stoyan-shopov/vx-probe-blackmagic-v2-kicad/vx-probe-black-magic-v2.kicad_pcb

## KiCad design vx-probe-black-magic-v2.kicad_pcb (2016-10-07)

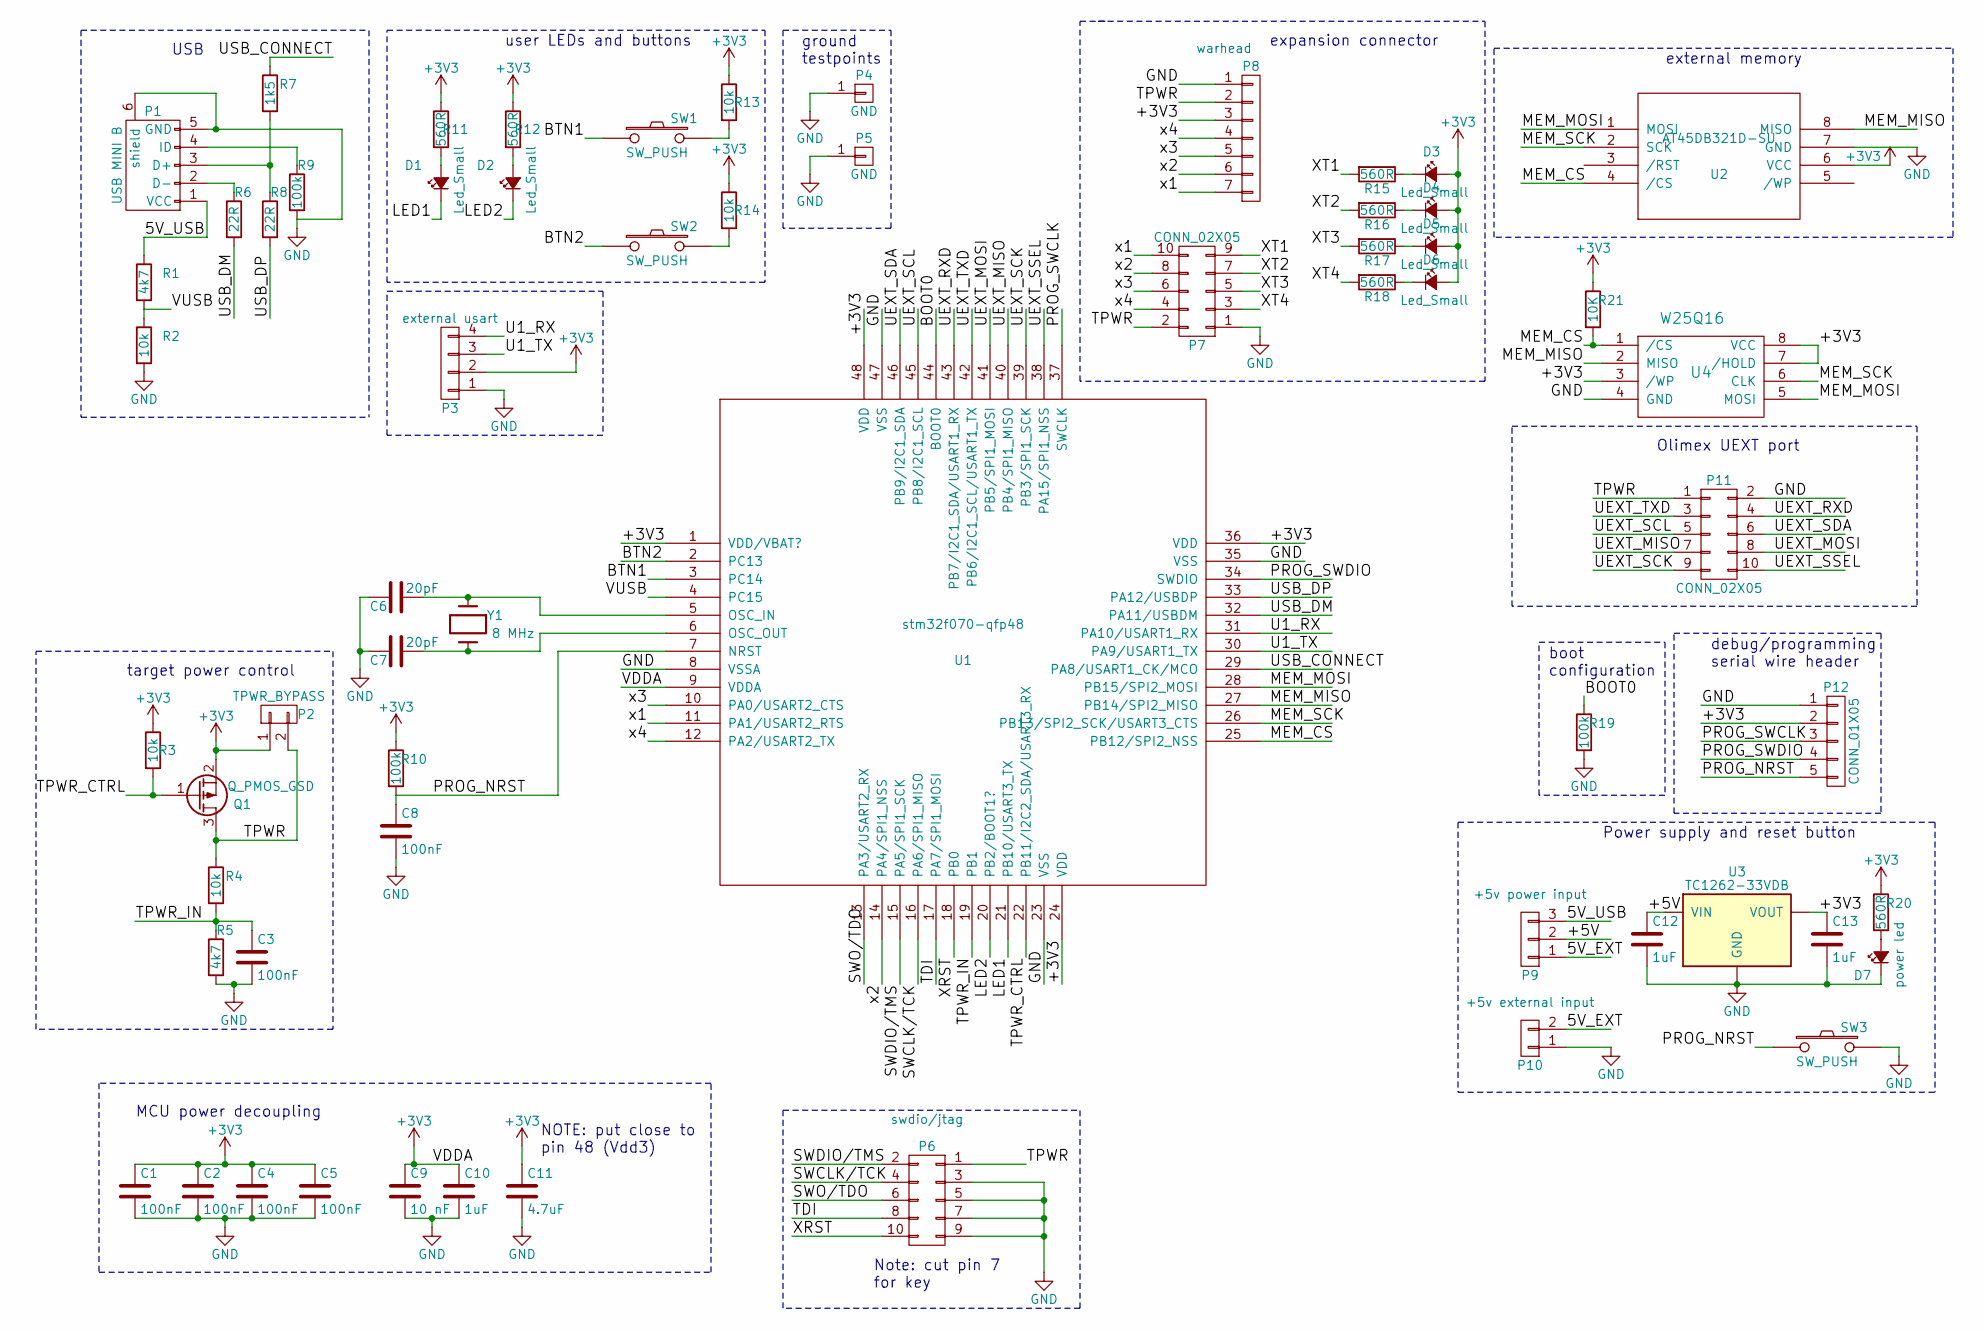
[picture p2: schematic vx-probe-black-magic-v2.sch]

Parts:
C1, C2, C3, C4, C5, C8: 100nF; C_0805
C6, C7: 20pF; C_0805
C9: 10 nF; C_0805
C10, C12, C13: 1uF; C_0805
C11: 4.7uF; C_0805
D1, D2, D3, D4, D5, D6: Led_Small; LED_0805
D7: power led; LED_0805
P1: USB MINI B; USB_Mini-B
P2: TPWR_BYPASS; Pin_Header_Straight_1x02
P3: external usart; Pin_Header_Straight_1x04
P4, P5: GND; Pin_Header_Straight_1x01
P6: swdio/jtag; IDC_Header_Straight_10pins
P7: CONN_02X05; Pin_Header_Straight_2x05
P8: warhead; Pin_Header_Straight_1x07
P9: +5v power input; Pin_Header_Straight_1x03
P10: +5v external input; Pin_Header_Straight_1x02
P11: CONN_02X05; IDC_Header_Straight_10pins
P12: CONN_01X05; Pin_Header_Straight_1x05
Q1: Q_PMOS_GSD; SOT-23
R1, R5: 4k7; R_0805
R2, R3, R4, R13, R14: 10k; R_0805
R6, R8: 22R; R_0805
R7: 1k5; R_0805
R9, R10, R19: 100k; R_0805
R11, R12, R15, R16, R17, R18, R20: 560R; R_0805
R21: 10K; R_0805
SW1, SW2, SW3: SW_PUSH; SW_PUSH_6mm
U1: stm32f070-qfp48; LQFP-48_7x7mm_Pitch0.5mm
U2: AT45DB321D-SU; SOIJ-8_5.3x5.3mm_Pitch1.27mm
U3: TC1262-33VDB; SOT-223
U4: W25Q16; SOIJ-8_5.3x5.3mm_Pitch1.27mm
Y1: 8 MHz; Crystal_HC49-U_Vertical

Connections:
+3V3: C1.1, C2.1, C4.1, C5.1, C9.1, C10.1, C11.1, C13.1, D3.2 (A), D4.2 (A), D5.2 (A), D6.2 (A), P2.1, P3.2, P8.3, P12.2, Q1.2 (S), R3.1, R10.1, R11.1, R12.1, R13.1, R14.1, R20.1, R21.1, U1.1 (VDD/VBAT?), U1.9 (VDDA), U1.24 (VDD), U1.36 (VDD), U1.48 (VDD), U2.6 (VCC), U3.3 (VOUT), U4.3 (/WP), U4.7 (/HOLD), U4.8 (VCC)
/5V_EXT: P9.1, P10.2
/5V_USB: P1.1 (VCC), P9.3, R1.1
/+5V: C12.1, P9.2, U3.1 (VIN)
/BOOT0: R19.1, U1.44 (BOOT0)
/BTN1: SW1.1, U1.3 (PC14)
/BTN2: SW2.1, U1.2 (PC13)
/LED1: D1.1 (K), U1.21 (PB10/USART3_TX)
/LED2: D2.1 (K), U1.20 (PB2/BOOT1?)
/MEM_CS: R21.2, U1.25 (PB12/SPI2_NSS), U2.4 (/CS), U4.1 (/CS)
/MEM_MISO: U1.27 (PB14/SPI2_MISO), U2.8 (MISO), U4.2 (MISO)
/MEM_MOSI: U1.28 (PB15/SPI2_MOSI), U2.1 (MOSI), U4.5 (MOSI)
/MEM_SCK: U1.26 (PB13/SPI2_SCK/USART3_CTS), U2.2 (SCK), U4.6 (CLK)
/PROG_NRST: C8.1, P12.5, R10.2, SW3.1, U1.7 (NRST)
/PROG_SWCLK: P12.3, U1.37 (SWCLK)
/PROG_SWDIO: P12.4, U1.34 (SWDIO)
/SWCLK/TCK: P6.4, U1.16 (PA6/SPI1_MISO)
/SWDIO/TMS: P6.2, U1.15 (PA5/SPI1_SCK)
/SWO/TDO: P6.6, U1.13 (PA3/USART2_RX)
/TDI: P6.8, U1.17 (PA7/SPI1_MOSI)
/TPWR: P2.2, P6.1, P7.2, P8.2, P11.1, Q1.3 (D), R4.1
/TPWR_CTRL: Q1.1 (G), R3.2, U1.22 (PB11/I2C2_SDA/USART3_RX)
/TPWR_IN: C3.1, R4.2, R5.1, U1.19 (PB1)
/U1_RX: P3.4, U1.31 (PA10/USART1_RX)
/U1_TX: P3.3, U1.30 (PA9/USART1_TX)
/UEXT_MISO: P11.7, U1.40 (PB4/SPI1_MISO)
/UEXT_MOSI: P11.8, U1.41 (PB5/SPI1_MOSI)
/UEXT_RXD: P11.4, U1.43 (PB7/I2C1_SDA/USART1_RX)
/UEXT_SCK: P11.9, U1.39 (PB3/SPI1_SCK)
/UEXT_SCL: P11.5, U1.45 (PB8/I2C1_SCL)
/UEXT_SDA: P11.6, U1.46 (PB9/I2C1_SDA)
/UEXT_SSEL: P11.10, U1.38 (PA15/SPI1_NSS)
/UEXT_TXD: P11.3, U1.42 (PB6/I2C1_SCL/USART1_TX)
/USB_CONNECT: R7.1, U1.29 (PA8/USART1_CK/MCO)
/USB_DM: R6.2, U1.32 (PA11/USBDM)
/USB_DP: R8.2, U1.33 (PA12/USBDP)
/VUSB: R1.2, R2.1, U1.4 (PC15)
/XRST: P6.10, U1.18 (PB0)
/XT1: P7.9, R15.2
/XT2: P7.7, R16.2
/XT3: P7.5, R17.2
/XT4: P7.3, R18.2
/x1: P7.10, P8.7, U1.11 (PA1/USART2_RTS)
/x2: P7.8, P8.6, U1.14 (PA4/SPI1_NSS)
/x3: P7.6, P8.5, U1.10 (PA0/USART2_CTS)
/x4: P7.4, P8.4, U1.12 (PA2/USART2_TX)
GND: C1.2, C2.2, C3.2, C4.2, C5.2, C6.2, C7.2, C8.2, C9.2, C10.2, C11.2, C12.2, C13.2, D7.1 (K), P1.5 (GND), P1.6 (shield), P3.1, P4.1, P5.1, P6.3, P6.5, P6.7, P6.9, P7.1, P8.1, P10.1, P11.2, P12.1, R2.2, R5.2, R9.2, R19.2, SW3.2, U1.8 (VSSA), U1.23 (VSS), U1.35 (VSS), U1.47 (VSS), U2.7 (GND), U3.2 (GND), U3.4 (GND), U4.4 (GND)
unnamed: C6.1, U1.5 (OSC_IN), Y1.1
unnamed: C7.1, U1.6 (OSC_OUT), Y1.2
unnamed: D1.2 (A), R11.2
unnamed: D2.2 (A), R12.2
unnamed: D3.1 (K), R15.1
unnamed: D4.1 (K), R16.1
unnamed: D5.1 (K), R17.1
unnamed: D6.1 (K), R18.1
unnamed: D7.2 (A), R20.2
unnamed: P1.2 (D-), R6.1
unnamed: P1.3 (D+), R7.2, R8.1
unnamed: P1.4 (ID), R9.1
unnamed: R13.2, SW1.2
unnamed: R14.2, SW2.2

Notes on the sheet:
MCU power decoupling
USB
external memory
Olimex UEXT port
NOTE: put close to pin 48 (Vdd3)
debug/programming serial wire header
boot configuration
Power supply and reset button
Note: cut pin 7 for key
user LEDs and buttons
ground testpoints
expansion connector
target power control

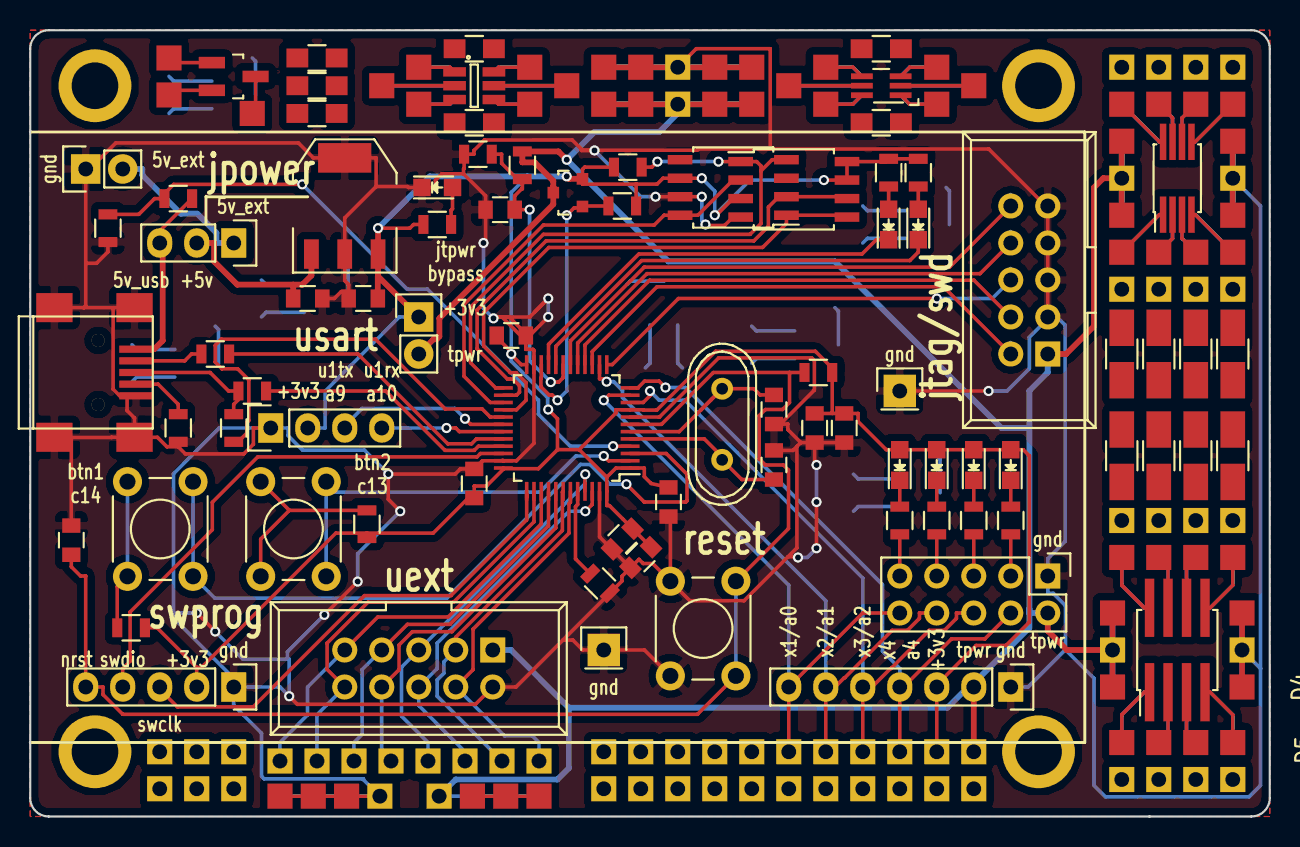
[picture p3: board vx-probe-black-magic-v2.kicad_pcb from above]

Board: 2 copper layers, 85.1 x 54.0 mm, 62 parts (0 on the bottom side), 61 nets.
