stoyan-shopov/vx-probe-blackmagic-v2-kicad/(commit log)

2016-09-13 new project created
    [vx-probe-black-magic-v2.kicad_pcb, vx-probe-black-magic-v2.sch]
2016-09-13 stm32f103 part datasheet added
2016-09-13 started schematics drawing
    [vx-probe-black-magic-v2.sch]
2016-09-13 reset circuit added
    [vx-probe-black-magic-v2.sch]
2016-09-13 started assigning component footprints
    [vx-probe-black-magic-v2.sch]
2016-09-13 added the mcu power decoupling
    [vx-probe-black-magic-v2.sch]
2016-09-13 drew the usb connection
    [vx-probe-black-magic-v2.sch]
2016-09-13 assigned more component footprints
    [vx-probe-black-magic-v2.sch]
2016-09-13 updated the pcb
    [vx-probe-black-magic-v2.kicad_pcb]
2016-09-13 added the at45db32 library part
    [vx-probe-black-magic-v2.sch]
2016-09-13 assigned the at45db32 part footprint
    [vx-probe-black-magic-v2.kicad_pcb, vx-probe-black-magic-v2.sch]
2016-09-13 wired up the external spi memory
    [vx-probe-black-magic-v2.sch]
2016-09-13 wired up the olimex UEXT port
    [vx-probe-black-magic-v2.sch]
2016-09-13 added the original blackmagic probe schematics for reference
2016-09-13 added missing pull-up resistor on the usb-data-plus line
    [vx-probe-black-magic-v2.sch]
2016-09-13 added serial wire debug/programming header
    [vx-probe-black-magic-v2.sch]
2016-09-13 added boot selection setup
    [vx-probe-black-magic-v2.sch]
2016-09-13 added power supply block
    [vx-probe-black-magic-v2.sch]
2016-09-13 made capacitor values more readable
    [vx-probe-black-magic-v2.sch]
2016-09-13 updated components' annotations and footprints
    [vx-probe-black-magic-v2.kicad_pcb, vx-probe-black-magic-v2.sch]
2016-09-13 added missing wires, started placing components
    [vx-probe-black-magic-v2.kicad_pcb, vx-probe-black-magic-v2.sch]
2016-09-14 adjusted minimum via diametercls
    [vx-probe-black-magic-v2.kicad_pcb]
2016-09-14 pcb manufacturer document file added
2016-09-14 started placing and routing the swdio/jtag connector
    [vx-probe-black-magic-v2.kicad_pcb, vx-probe-black-magic-v2.sch]
2016-09-14 routing optimizations
    [vx-probe-black-magic-v2.kicad_pcb, vx-probe-black-magic-v2.sch]
2016-09-14 7 vias
    [vx-probe-black-magic-v2.kicad_pcb]
2016-09-14 9 vias
    [vx-probe-black-magic-v2.kicad_pcb]
2016-09-14 8 vias
    [vx-probe-black-magic-v2.kicad_pcb]
2016-09-15 11 vias
    [vx-probe-black-magic-v2.kicad_pcb, vx-probe-black-magic-v2.sch]
2016-09-15 removed i2c bus pull-up resistors
    [vx-probe-black-magic-v2.kicad_pcb, vx-probe-black-magic-v2.sch]
2016-09-15 stm32f070 breakout board schematics added for reference
2016-09-15 stm nucleo-64 boards user manual added for reference
2016-09-15 reorganized layout, autorouting to 7 vias
    [vx-probe-black-magic-v2.kicad_pcb]
2016-09-15 defined board dimensions
    [vx-probe-black-magic-v2.kicad_pcb]
2016-09-15 started fitting the components inside the board space, autorouting to 14 vias
    [vx-probe-black-magic-v2.kicad_pcb]
2016-09-15 autorouting to 8 vias
    [vx-probe-black-magic-v2.kicad_pcb]
2016-09-15 displaced the connectors, autorouting to 8 vias
    [vx-probe-black-magic-v2.kicad_pcb]
2016-09-15 adding dummy keep-off areas
    [vx-probe-black-magic-v2.kicad_pcb, vx-probe-black-magic-v2.sch]
2016-09-15 adding dummy keep-off areas, autorouting to 9 vias
    [vx-probe-black-magic-v2.kicad_pcb]
2016-09-15 adding dummy keep-off areas, autorouting to 5 vias
    [vx-probe-black-magic-v2.kicad_pcb]
2016-09-15 placed unused pins utilization connector, autorouting to 13 vias
    [vx-probe-black-magic-v2.kicad_pcb, vx-probe-black-magic-v2.sch]
2016-09-15 bundled tracks closer to each other
    [vx-probe-black-magic-v2.kicad_pcb, vx-probe-black-magic-v2.sch]
2016-09-15 test-routed unused pins
    [vx-probe-black-magic-v2.kicad_pcb]
2016-09-15 bundled the uext signals closer together
    [vx-probe-black-magic-v2.kicad_pcb]
2016-09-16 track layout optimizations
    [vx-probe-black-magic-v2.kicad_pcb]
2016-09-16 added target power control circuitry
    [vx-probe-black-magic-v2.sch]
2016-09-16 initial routing of the target power control circuitry
    [vx-probe-black-magic-v2.kicad_pcb, vx-probe-black-magic-v2.sch]
2016-09-16 added and routed the 'vbus' usb power detection signal
    [vx-probe-black-magic-v2.kicad_pcb, vx-probe-black-magic-v2.sch]
2016-09-16 routed an unused pin to the 'unused pins' connector
    [vx-probe-black-magic-v2.kicad_pcb, vx-probe-black-magic-v2.sch]
2016-09-16 reorganized the unused pins connector
    [vx-probe-black-magic-v2.kicad_pcb, vx-probe-black-magic-v2.sch]
2016-09-16 placed and routed the reset button and a serial port
    [vx-probe-black-magic-v2.kicad_pcb, vx-probe-black-magic-v2.sch]
2016-09-16 added a pull-up resistor on the target power enable switch (pmosfet)
    [vx-probe-black-magic-v2.kicad_pcb, vx-probe-black-magic-v2.sch]
2016-09-16 moved the crystal closer to the microcontroller
    [vx-probe-black-magic-v2.kicad_pcb]
2016-09-16 changed the jtag and uext connectors to idc headers
    [vx-probe-black-magic-v2.kicad_pcb, vx-probe-black-magic-v2.sch]
2016-09-16 displaced the jtag connector
    [vx-probe-black-magic-v2.kicad_pcb]
2016-09-16 bundled the jtag signals closer together
    [vx-probe-black-magic-v2.kicad_pcb]
2016-09-16 made the power-to-target tracks thicker
    [vx-probe-black-magic-v2.kicad_pcb]
2016-09-17 added a button
    [vx-probe-black-magic-v2.kicad_pcb, vx-probe-black-magic-v2.sch]
2016-09-19 added another button - this adds 4 vias!!!
    [vx-probe-black-magic-v2.kicad_pcb, vx-probe-black-magic-v2.sch]
2016-09-19 rerouted the extension connector
    [vx-probe-black-magic-v2.kicad_pcb, vx-probe-black-magic-v2.sch]
2016-09-19 optimized extension connector routing
    [vx-probe-black-magic-v2.kicad_pcb, vx-probe-black-magic-v2.sch]
2016-09-19 added two led-s
    [vx-probe-black-magic-v2.kicad_pcb, vx-probe-black-magic-v2.sch]
2016-09-19 renamed extension connector signals
    [vx-probe-black-magic-v2.kicad_pcb, vx-probe-black-magic-v2.sch]
2016-09-19 rerouted many pins because of pc13-pc15 output driving limitations
    [vx-probe-black-magic-v2.kicad_pcb, vx-probe-black-magic-v2.sch]
2016-09-19 rerouting, !!! design rules violations present !!!
    [vx-probe-black-magic-v2.kicad_pcb, vx-probe-black-magic-v2.sch]
2016-09-19 rerouting, solved design violations
    [vx-probe-black-magic-v2.kicad_pcb]
2016-09-19 routing optimizations - leds still unrouted
    [vx-probe-black-magic-v2.kicad_pcb, vx-probe-black-magic-v2.sch]
2016-09-19 rerouting, moved the vusb resistor divider
    [vx-probe-black-magic-v2.kicad_pcb]
2016-09-19 switched two wires on the jtag connector
    [vx-probe-black-magic-v2.kicad_pcb, vx-probe-black-magic-v2.sch]
2016-09-19 rewired the extension connector
    [vx-probe-black-magic-v2.kicad_pcb, vx-probe-black-magic-v2.sch]
2016-09-19 moved the extension port enable connector
    [vx-probe-black-magic-v2.kicad_pcb]
2016-09-19 board fully routed
    [vx-probe-black-magic-v2.kicad_pcb, vx-probe-black-magic-v2.sch]
2016-09-19 made the target power supply track thicker
    [vx-probe-black-magic-v2.kicad_pcb]
2016-09-19 added a target power-enable bypass jumper
    [vx-probe-black-magic-v2.kicad_pcb, vx-probe-black-magic-v2.sch]
2016-09-19 added a +3v3 wire to the serial port connector
    [vx-probe-black-magic-v2.kicad_pcb, vx-probe-black-magic-v2.sch]
2016-09-19 moved the olimex uext connector
    [vx-probe-black-magic-v2.kicad_pcb]
2016-09-19 added a +3v3 wire to the programming connector
    [vx-probe-black-magic-v2.kicad_pcb, vx-probe-black-magic-v2.sch]
2016-09-19 added a ground testpoint
    [vx-probe-black-magic-v2.kicad_pcb, vx-probe-black-magic-v2.sch]
2016-09-19 added ground zone fills
    [vx-probe-black-magic-v2.kicad_pcb]
2016-09-19 added unconnected zone fills (copper islands)
    [vx-probe-black-magic-v2.kicad_pcb]
2016-09-19 board cleanup
    [vx-probe-black-magic-v2.kicad_pcb, vx-probe-black-magic-v2.sch]
2016-09-19 reannotated the board
    [vx-probe-black-magic-v2.kicad_pcb, vx-probe-black-magic-v2.sch]
2016-09-19 cleaned up the schematic
    [vx-probe-black-magic-v2.kicad_pcb, vx-probe-black-magic-v2.sch]
2016-09-19 reannotated the schematic
    [vx-probe-black-magic-v2.kicad_pcb, vx-probe-black-magic-v2.sch]
2016-09-19 moved the board to the center of the sheet
    [vx-probe-black-magic-v2.kicad_pcb]
2016-09-19 tried the new kicad open-gl routing features - shove and others; slight optimizations
    [vx-probe-black-magic-v2.kicad_pcb]
2016-09-19 filled zones again
    [vx-probe-black-magic-v2.kicad_pcb]
2016-09-20 made power tracks thicker
    [vx-probe-black-magic-v2.kicad_pcb]
2016-09-20 performed a 'cleanup tracks and vias' operation in the pcb editor
    [vx-probe-black-magic-v2.kicad_pcb]
2016-09-20 moved the reset button
    [vx-probe-black-magic-v2.kicad_pcb]
2016-09-20 added the W25Q16 spi memory datasheet for reference
2016-09-20 performed a board cleanup ('cleanup tracks and vias')
    [vx-probe-black-magic-v2.kicad_pcb]
2016-09-20 moved component values and references out of the pcb space
    [vx-probe-black-magic-v2.kicad_pcb]
2016-09-20 added a footprint for a w25q16 spi memory
    [vx-probe-black-magic-v2.kicad_pcb, vx-probe-black-magic-v2.sch]
2016-09-20 minor track movement
    [vx-probe-black-magic-v2.kicad_pcb]
2016-09-20 drew the new board size outline
    [vx-probe-black-magic-v2.kicad_pcb]
2016-09-20 placed mounting holes
    [vx-probe-black-magic-v2.kicad_pcb]
2016-09-20 fitted the routed board in the new board size space
    [vx-probe-black-magic-v2.kicad_pcb]
2016-09-20 adjusted component positions
    [vx-probe-black-magic-v2.kicad_pcb]
2016-09-20 started placing pads on the extra board space
    [vx-probe-black-magic-v2.kicad_pcb]
2016-09-20 placing pads on the extra board space
    [vx-probe-black-magic-v2.kicad_pcb]
2016-09-20 placing pads on the extra board space - put ssop and soic footprints
    [vx-probe-black-magic-v2.kicad_pcb]
2016-09-21 cleaned board, started adding standard footprints for prototyping
    [vx-probe-black-magic-v2.kicad_pcb]
2016-09-21 edited a prototype footprint
    [vx-probe-black-magic-v2.kicad_pcb]
2016-09-21 made a new footprint
    [vx-probe-black-magic-v2.kicad_pcb]
2016-09-21 rerouted the expansion jtag wirings
    [vx-probe-black-magic-v2.kicad_pcb]
2016-09-21 added a prototyping footprint
    [vx-probe-black-magic-v2.kicad_pcb]
2016-09-21 optimized prototyping jtag connector wiring
    [vx-probe-black-magic-v2.kicad_pcb]
2016-09-21 added prototyping pads
    [vx-probe-black-magic-v2.kicad_pcb]
2016-09-21 modifying prototype design
    [vx-probe-black-magic-v2.kicad_pcb]
2016-09-21 optimized jtag connector wiring
    [vx-probe-black-magic-v2.kicad_pcb]
2016-09-21 optimized spi memory routing
    [vx-probe-black-magic-v2.kicad_pcb]
2016-09-21 moved the mounting holes
    [vx-probe-black-magic-v2.kicad_pcb]
2016-09-21 routing the prototype board area
    [vx-probe-black-magic-v2.kicad_pcb]
2016-09-21 working on the prototyping board area
    [vx-probe-black-magic-v2.kicad_pcb]
2016-09-21 prototyping board area cleanup
    [vx-probe-black-magic-v2.kicad_pcb]
2016-09-24 prototyping board area changes
    [vx-probe-black-magic-v2.kicad_pcb]
2016-09-26 populated the prototyping board area with component footprints
    [vx-probe-black-magic-v2.kicad_pcb]
2016-09-26 added pads to the prototyping board area
    [vx-probe-black-magic-v2.kicad_pcb]
2016-09-26 removed extra pads and footprints
    [vx-probe-black-magic-v2.kicad_pcb]
2016-09-26 routed the prototyping connectors
    [vx-probe-black-magic-v2.kicad_pcb]
2016-09-26 routed power lines to the prototyping board area
    [vx-probe-black-magic-v2.kicad_pcb]
2016-09-26 routed some of the prototyping footprints
    [vx-probe-black-magic-v2.kicad_pcb]
2016-09-26 fully routed the prototyping board area
    [vx-probe-black-magic-v2.kicad_pcb]
2016-09-26 added extra sot23 prototyping footprint clusters
    [vx-probe-black-magic-v2.kicad_pcb]
2016-09-26 added filled ground zones
    [vx-probe-black-magic-v2.kicad_pcb]
2016-09-26 added a few pads to the prototyping board area
    [vx-probe-black-magic-v2.kicad_pcb]
2016-09-26 stiched ground zones with vias
    [vx-probe-black-magic-v2.kicad_pcb]
2016-09-26 added copper islands
    [vx-probe-black-magic-v2.kicad_pcb]
2016-09-26 renumbered warhead connector pins
    [vx-probe-black-magic-v2.kicad_pcb, vx-probe-black-magic-v2.sch]
2016-09-26 optimized warhead connector wiring
    [vx-probe-black-magic-v2.kicad_pcb]
2016-09-26 started adding silkscreen test; routed some power lines on the prototype board area
    [vx-probe-black-magic-v2.kicad_pcb]
2016-09-26 adding silkscreen text
    [vx-probe-black-magic-v2.kicad_pcb]
2016-09-27 slightly moved a decoupling capacitor
    [vx-probe-black-magic-v2.kicad_pcb]
2016-09-27 board finalization for manufacturing
    [vx-probe-black-magic-v2.kicad_pcb]
2016-09-27 slightly modified the usb connector footprint; fabrication settings adjustments
    [vx-probe-black-magic-v2.kicad_pcb]
2016-09-27 changed via diameters as per fabrication house recommendations
    [vx-probe-black-magic-v2.kicad_pcb]
2016-10-07 positioned component values for easy hand-soldering reference
    [vx-probe-black-magic-v2.kicad_pcb]
